harrisonLet/ALANv/docs/3992_final/references.tex

\begin{thebibliography}{9}

\bibitem{stekzer2012}
R.~Stekzer, "Autonomous Sailboat Navigation," Ph.D. dissertation, Center for Computational Intelligence, De Montfort University, Leicester, 2012. [Online]. Available: \url{https://files01.core.ac.uk/download/pdf/228200594.pdf}

\bibitem{saildrone}
Saildrone. [Online]. Available: \url{https://www.saildrone.com/}

\bibitem{noahmarine}
"Ship Rudder," Noah Marine Services. [Online]. Available: \url{https://noah-marineservices.com/ship-rudder-parts-marine-parts/}

\bibitem{sailwings}
"Self Trimming Wingsail---the Pulley/Cord Control System," Sailwings.net, 2026. [Online]. Available: \url{https://www.sailwings.net/pulleycord.html}

\bibitem{sailingcatamarans}
"Keels or Daggerboards, the Pros and Cons," Sailingcatamarans.com. [Online]. Available: \url{https://www.sailingcatamarans.com/index.php/articles/12-to-be-published-mainly-technical/53-keels-or-daggerboards-the-pros-and-cons} (accessed Mar.~22, 2026).

\bibitem{skene2001}
N.~L.~Skene, \emph{Elements of Yacht Design}. Dobbs Ferry, NY: Sheridan House, 2001.

\bibitem{sun2024}
Z.~Sun, A.~Feng, J.~Yu, W.~Zhao, and Y.~Huang, "Development of autonomous sailboat sails and future perspectives: A review," \emph{Renewable and Sustainable Energy Reviews}, vol.~207, no.~114918, Sep.~2024, doi: \url{https://doi.org/10.1016/j.rser.2024.114918}.

\end{thebibliography}
