harrisonLet/ALANv/docs/3992_final/figures/gantt.tex

% ---------------------------------------------------

\begin{table*}[htbp]
\centering
\caption{Project Gantt Chart}
\label{tab:gantt}
\footnotesize
\setlength{\tabcolsep}{2pt}
\newcommand{\gb}{\rule{0.85cm}{5pt}}
\begin{tabular}{|p{3.5cm}|c|c|c|c|c|c|c|c|c|c|c|c|}
\hline
\textbf{Task} & \textbf{Jan} & \textbf{Feb} & \textbf{Mar} & \textbf{Apr} & \textbf{May} & \textbf{Jun} & \textbf{Jul} & \textbf{Aug} & \textbf{Sep} & \textbf{Oct} & \textbf{Nov} & \textbf{Dec} \\
\hline
Hull & \gb & \gb & \gb & \gb & \gb & \gb & & & & & & \\
\hline
Sail & & \gb & \gb & \gb & \gb & \gb & \gb & & & & & \\
\hline
Rudder & & \gb & \gb & \gb & \gb & \gb & & & & & & \\
\hline
Keel & & \gb & \gb & \gb & \gb & \gb & & & & & & \\
\hline
Complete Boat & \gb & \gb & \gb & \gb & \gb & \gb & \gb & & & & & \\
\hline
LoRa & & & \gb & \gb & \gb & \gb & \gb & \gb & \gb & & & \\
\hline
Servos & & \gb & \gb & \gb & \gb & \gb & \gb & \gb & & & & \\
\hline
Sensors & & & \gb & \gb & \gb & \gb & \gb & \gb & \gb & & & \\
\hline
MCU & & & \gb & \gb & \gb & \gb & \gb & \gb & \gb & \gb & & \\
\hline
RC Boat & & & & \gb & \gb & \gb & \gb & \gb & \gb & & & \\
\hline
Positioning & & & & & & & & \gb & \gb & \gb & & \\
\hline
Self Trimming Wingsail & & & & & & & & \gb & \gb & \gb & & \\
\hline
Path Planning & & & & & & & & & \gb & \gb & \gb & \\
\hline
Emergency Recovery & & & & & & & & & & \gb & \gb & \\
\hline
Ground Station Interface & & & & & & & & \gb & \gb & \gb & & \\
\hline
Autonomous Sailboat & & & & & & & & & & \gb & \gb & \gb \\
\hline
\end{tabular}
\end{table*}

% ---------------------------------------------------
