harrisonLet/ALANv/docs/3992_final/sections/conclusion.tex

% ---------------------------------------------------

\section{Conclusion}
\label{sec:conclusion}

The ALAN project demonstrates the feasibility of constructing a low-cost autonomous sailboat using accessible manufacturing techniques and off-the-shelf electronic components. By combining a trimaran hull design with a self-trimming rigid wingsail, the vessel achieves propulsion efficiency without the power consumption of motor-driven sail actuation. The use of a dual-core STM32H755 running FreeRTOS provides the real-time performance required for sensor fusion and control, while LoRa radio enables long-range communication suitable for open-water operation.

Key contributions of this project include: a fiberglass hull manufacturing process using 3D-printed molds accessible to university fabrication labs; a modular mechanical design allowing independent development and testing of keel, rudder, and sail subsystems; and an embedded software architecture distributing navigation and communication across dual processor cores.

Future work includes integration of solar charging for extended mission duration, implementation of machine-learning-based path planning for complex wind conditions, full blue-water endurance testing, and expansion of the sensor suite for environmental data collection applications. The modular design of ALAN facilitates iterative improvement across all subsystems.

% ---------------------------------------------------
