harrisonLet/ALANv/docs/3992_final/figures/images/boatAanatomy_sailTypes.png

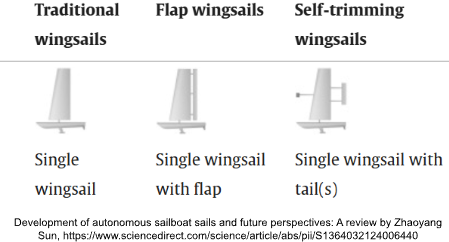
docs/3992_final/figures/images/boatAanatomy_sailTypes.png
