harrisonLet/ALANv/docs/3992_final/figures/images/boatAnatomy_hulls.png

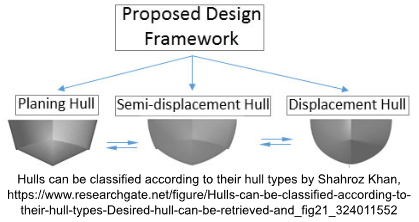
docs/3992_final/figures/images/boatAnatomy_hulls.png
