harrisonLet/ALANv/docs/3992_final/figures/images/selfTrimmingWingsail2.png

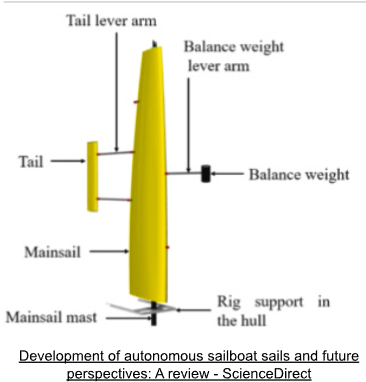
docs/3992_final/figures/images/selfTrimmingWingsail2.png
