harrisonLet/ALANv/docs/3992_final/figures/bom.tex

% ---------------------------------------------------

\begin{table*}[htbp]
\label{tab:bom_rudder}
\centering
\caption{Bill of Materials -- Rudder}
\footnotesize
\begin{tabular}{|p{3.45cm}|p{5.5cm}|p{2.2cm}|p{4.75cm}|}
\hline
\textbf{Category} & \textbf{Item} & \textbf{Status} & \textbf{Notes} \\
\hline
Rudder - Shaft & Shaft Bearing & & R188 Ceramic 1/4 x 1/2 x 3/16 in. \\
\hline
Rudder - Shaft & Rudder Shaft & & SS 304 Round Bar (0.25 in. x 12 in.) \\
\hline
Rudder - Shaft & Rudder Plate & & 304 SS plate 0.25 in. \\
\hline
Rudder - Shaft & Rudder Cross Bolt, Barrel Nut & Delivered & 3/16 in. x 3/4 in. Aluminum Binding Post \\
\hline
Rudder - Mounting & Mounting Bolts & Delivered & 1/4-20 x 1-1/2 in. Zinc Plated Hex Bolt \\
\hline
Rudder - Mounting & Mounting Nuts & Delivered & 1/4-20 SS Nylon Insert Stop Nut \\
\hline
Rudder - Mounting & Mounting Washers & Delivered & 1/4 in. SS Flat Washer \\
\hline
Rudder - Mounting & Rear Mounting Plate & & 304 SS plate 0.25 in. \\
\hline
Rudder - Servo & Marine silicone grease (1 oz) & & \\
\hline
Rudder - Servo & Marine epoxy resin (small kit) & & \\
\hline
Rudder - Servo & Servo-Shaft Coupler & Ordered & 25 Tooth Spline to 1/4 in. Round Bore \\
\hline
Rudder - Servo & Rudder Servo & Delivered & DS3218 MG Digital Servo \\
\hline
Rudder - Servo & Servo Bolt & Delivered & M4-0.7x30mm Hex Bolt \\
\hline
Rudder - Servo & Servo Bolt Nut & & M4 SS Lock Nut \\
\hline
Rudder & PLA Filament & Lab Provided & \\
\hline
\end{tabular}
\end{table*}

\begin{table*}[htbp]
\label{tab:bom_keel}
\centering
\caption{Bill of Materials -- Keel}
\footnotesize
\begin{tabular}{|p{3.45cm}|p{5.5cm}|p{2.2cm}|p{4.75cm}|}
\hline
\textbf{Category} & \textbf{Item} & \textbf{Status} & \textbf{Notes} \\
\hline
Keel & Carbon fiber cloth & & Cover for completed assembly \\
\hline
Keel & Epoxy resin kit & & For composite layup \\
\hline
Keel - Structure & Keel Post & & SS 304 Square Bar (0.5 in. x 7 in.) \\
\hline
Keel - Structure & Keel Mounting Bracket & & 304 SS plate 0.25 in. \\
\hline
Keel - Structure & Mounting Bolts & Delivered & 1/4-20 x 1-1/2 in. Zinc Plated Hex Bolt \\
\hline
Keel - Structure & Mounting Nuts & Delivered & 1/4-20 SS Nylon Insert Stop Nut \\
\hline
Keel - Structure & Mounting Washers & Delivered & 1/4 in. SS Flat Washer \\
\hline
Keel - Structure & Keel Bulb & & SS 304 Round Tube (2 in. x 8.5 in.) \\
\hline
Keel - Structure & Steel Balls & Lab Provided & Ballast \\
\hline
Keel - Fin & Keel Cross Bolt, Barrel Nut & Delivered & 3/16 in. x 3/4 in. Aluminum Binding Post \\
\hline
Keel - Fin & PLA Filament & Lab Provided & \\
\hline
\end{tabular}
\end{table*}

\begin{table*}[htbp]
\label{tab:bom_hull}
\centering
\caption{Bill of Materials -- Hull}
\footnotesize
\begin{tabular}{|p{3.45cm}|p{5.5cm}|p{2.2cm}|p{4.75cm}|}
\hline
\textbf{Category} & \textbf{Item} & \textbf{Status} & \textbf{Notes} \\
\hline
Hull - Mold & Standard PLA Bambu filament & Lab Provided & \\
\hline
Hull - Mold & Rustoleum Filler/Sandable Primer & Purchased & \\
\hline
Hull - Mold & SprayMax 2K Topcoat High Gloss Black & ECE Request & \\
\hline
Hull - Mold & PARTALL Paste \#2 Wax & Delivered & \\
\hline
Hull - Mold & PARTALL Film \#10 PVA & ECE Request & \\
\hline
Hull - Glassing & Fiberglass Cloth Roll & ECE Request & 4 oz plain weave, 50 in. wide \\
\hline
Hull - Glassing & Econostitch Peel Ply & Delivered & \\
\hline
Hull - Glassing & TotalBoat 5:1 Marine Epoxy Kit & ECE Request & \\
\hline
Hull - Tools & Chip Paint Brushes (1 in., 24 pack) & Delivered & \\
\hline
Hull - Tools & Resin Epoxy Mixing Cups (50 pcs) & Delivered & \\
\hline
Hull - Tools & 3M Dynatron Spreaders (3 pack) & Delivered & \\
\hline
Hull - Tools & Wet/Dry Sandpaper Assortment & Purchased & \\
\hline
Hull - PPE & 3M Half Facepiece Respirator & Delivered & \\
\hline
Hull - PPE & 3M P100 Cartridge/Filter & Delivered & \\
\hline
Hull - PPE & Nitrile Exam Gloves & Delivered & \\
\hline
\end{tabular}
\end{table*}

\begin{table*}[htbp]
\label{tab:bom_sail}
\centering
\caption{Bill of Materials -- Rigid Sail}
\footnotesize
\begin{tabular}{|p{3.45cm}|p{5.5cm}|p{2.2cm}|p{4.75cm}|}
\hline
\textbf{Category} & \textbf{Item} & \textbf{Status} & \textbf{Notes} \\
\hline
Rigid Sail & 6061 Aluminum Mast (3 ft) & & \\
\hline
Rigid Sail & 6061 Aluminum Mast (alt. source) & & Metal Supermarket \\
\hline
Rigid Sail & Foam (XPS Rigid Board) & & \\
\hline
Rigid Sail & Cardboard & & \\
\hline
\end{tabular}
\end{table*}

\begin{table*}[htbp]
\label{tab:bom_electronics}
\centering
\caption{Bill of Materials -- Electronics}
\footnotesize
\begin{tabular}{|p{3.45cm}|p{5.5cm}|p{2.2cm}|p{4.75cm}|}
\hline
\textbf{Category} & \textbf{Item} & \textbf{Status} & \textbf{Notes} \\
\hline
Electronics & STM32H7 Dev Board & Delivered & \\
\hline
Electronics & RS485 to UART Adapter & & \\
\hline
Electronics - Sensors & Wind Vane Direction Sensor & Delivered & \\
\hline
Electronics - Sensors & 9-DoF IMU \& Magnetometer & Delivered & BNO055 \\
\hline
Electronics - Sensors & GPS Module & Delivered & NEO-6 \\
\hline
Electronics - Actuators & High-Torque Servo (20 kg-cm) & & Waterproof \\
\hline
Electronics - Power & Solar Panel (10 W, 12 V) & & \\
\hline
Electronics - Power & LiPo Battery (11.1 V, 3S) & & \\
\hline
Electronics - Power & Buck Converters (DC-DC) & & \\
\hline
Electronics - Power & 5 V and 12 V PDB & & \\
\hline
Electronics - Power & Battery BMS & & Overcharge/discharge protection \\
\hline
Electronics - Wireless & Adafruit RFM95W LoRa (915 MHz) & Delivered & \\
\hline
Electronics - Wireless & Adafruit Feather RP2040 w/ RFM95 & Lab Provided & \\
\hline
Electronics - Wireless & uFL SMT Antenna Connector & Delivered & \\
\hline
Electronics - Wireless & SMA to uFL Adapter Cable & & Comes with antennas \\
\hline
Electronics - Wireless & 10 dBi Whip Antenna w/ Adapters & Delivered & \\
\hline
Electronics - Wireless & SMA Male-Female Extension (5 ft) & Delivered & \\
\hline
\end{tabular}
\end{table*}

\begin{table*}[htbp]
\label{tab:bom_miscellaneous}
\centering
\caption{Bill of Materials -- Miscellaneous}
\footnotesize
\begin{tabular}{|p{3.45cm}|p{5.5cm}|p{2.2cm}|p{4.75cm}|}
\hline
\textbf{Category} & \textbf{Item} & \textbf{Status} & \textbf{Notes} \\
\hline
Misc & S6005-2RS Bearing & & 25 mm ID, deck mast partner \\
\hline
Misc & Pelican M60 & & \\
\hline
\end{tabular}
\end{table*}

% ---------------------------------------------------
