harrisonLet/ALANv/docs/3992_final/figures/images/boatAnatomy_parts.png

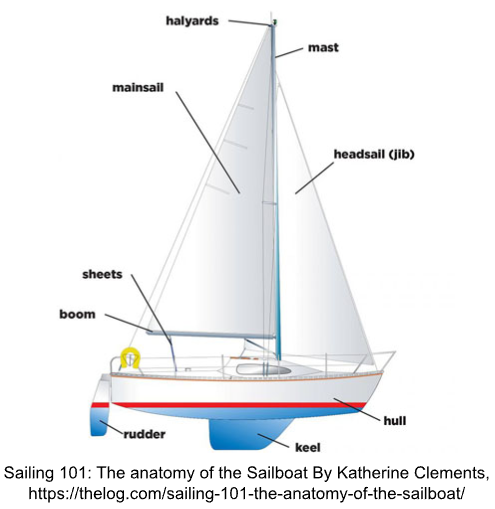
docs/3992_final/figures/images/boatAnatomy_parts.png
