harrisonLet/ALANv/sim/dashboard/models/keel.stl

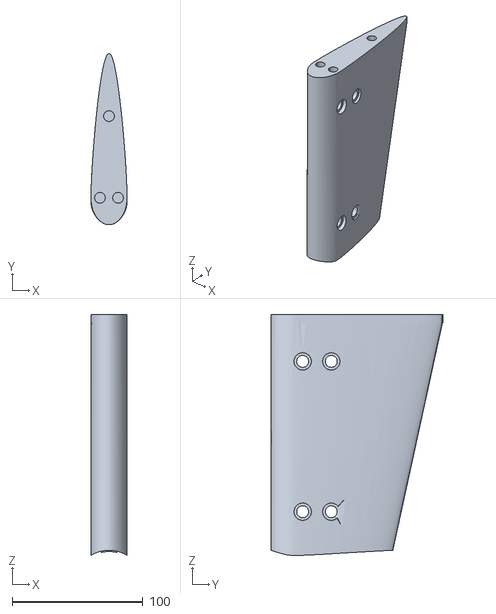
[picture p15: CAD file, 2026-11-07]
sim/dashboard/models/keel.stl
27.6 x 131.2 x 184.4
