harrisonLet/ALANv/sim/dashboard/models/hull_fittings.stl

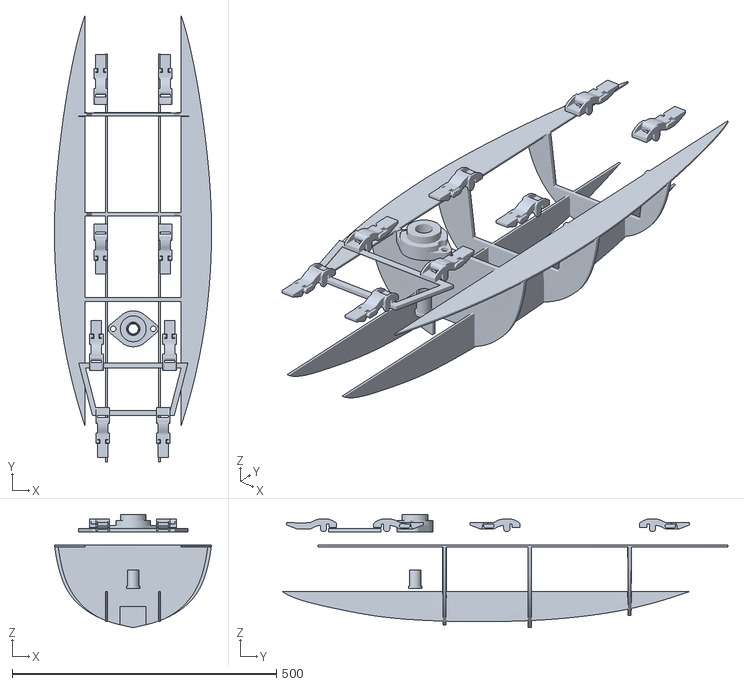
[picture p16: CAD file, 2026-11-07]
sim/dashboard/models/hull_fittings.stl
297.2 x 843.5 x 214.4
