harrisonLet/ALANv/sim/dashboard/models/tail.stl

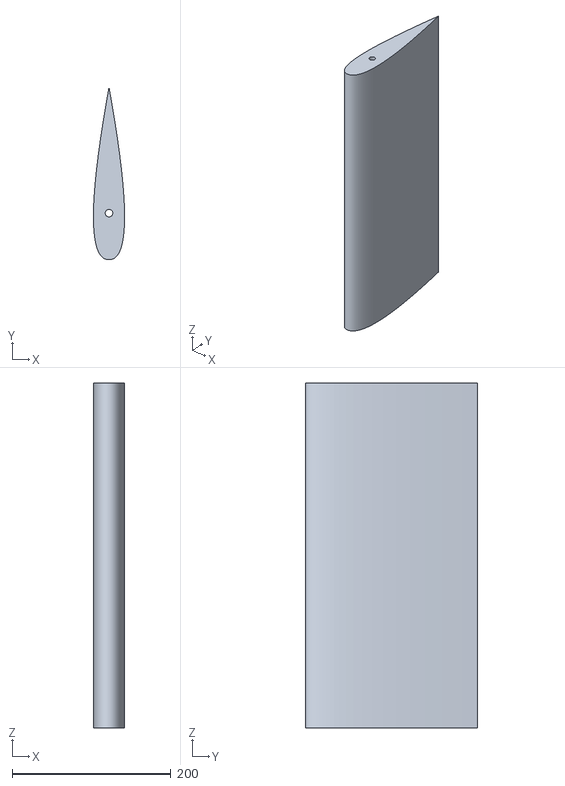
[picture p17: CAD file, 2026-11-07]
sim/dashboard/models/tail.stl
39.3 x 217.4 x 434.8
