harrisonLet/ALANv/hardware/Autonomous_Sailboat/Autonomous_Sailboat.kicad_sch

## KiCad design hardware/Autonomous_Sailboat/Autonomous_Sailboat.kicad_sch (2026-11-07, an earlier design)

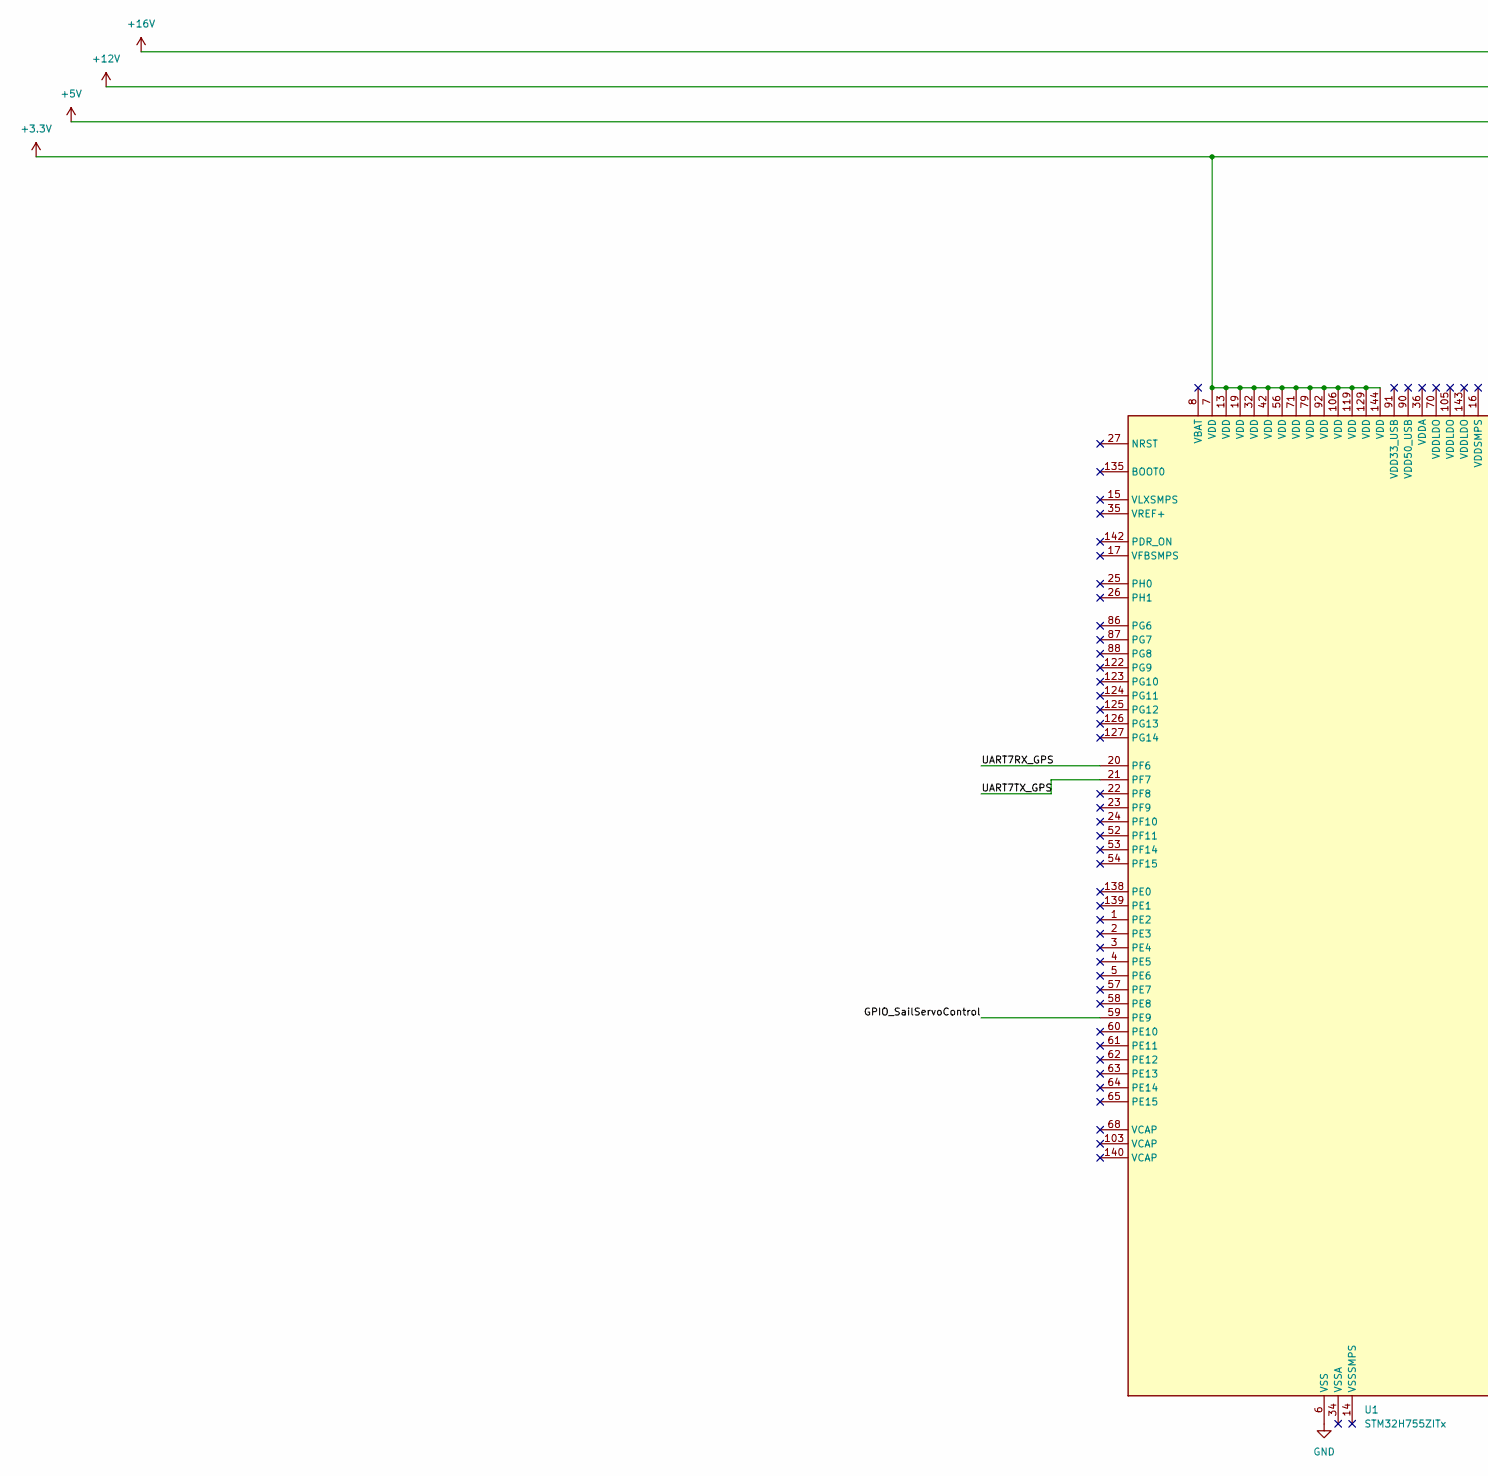
[picture p18: schematic Autonomous_Sailboat.kicad_sch, part in row 1, column 1]

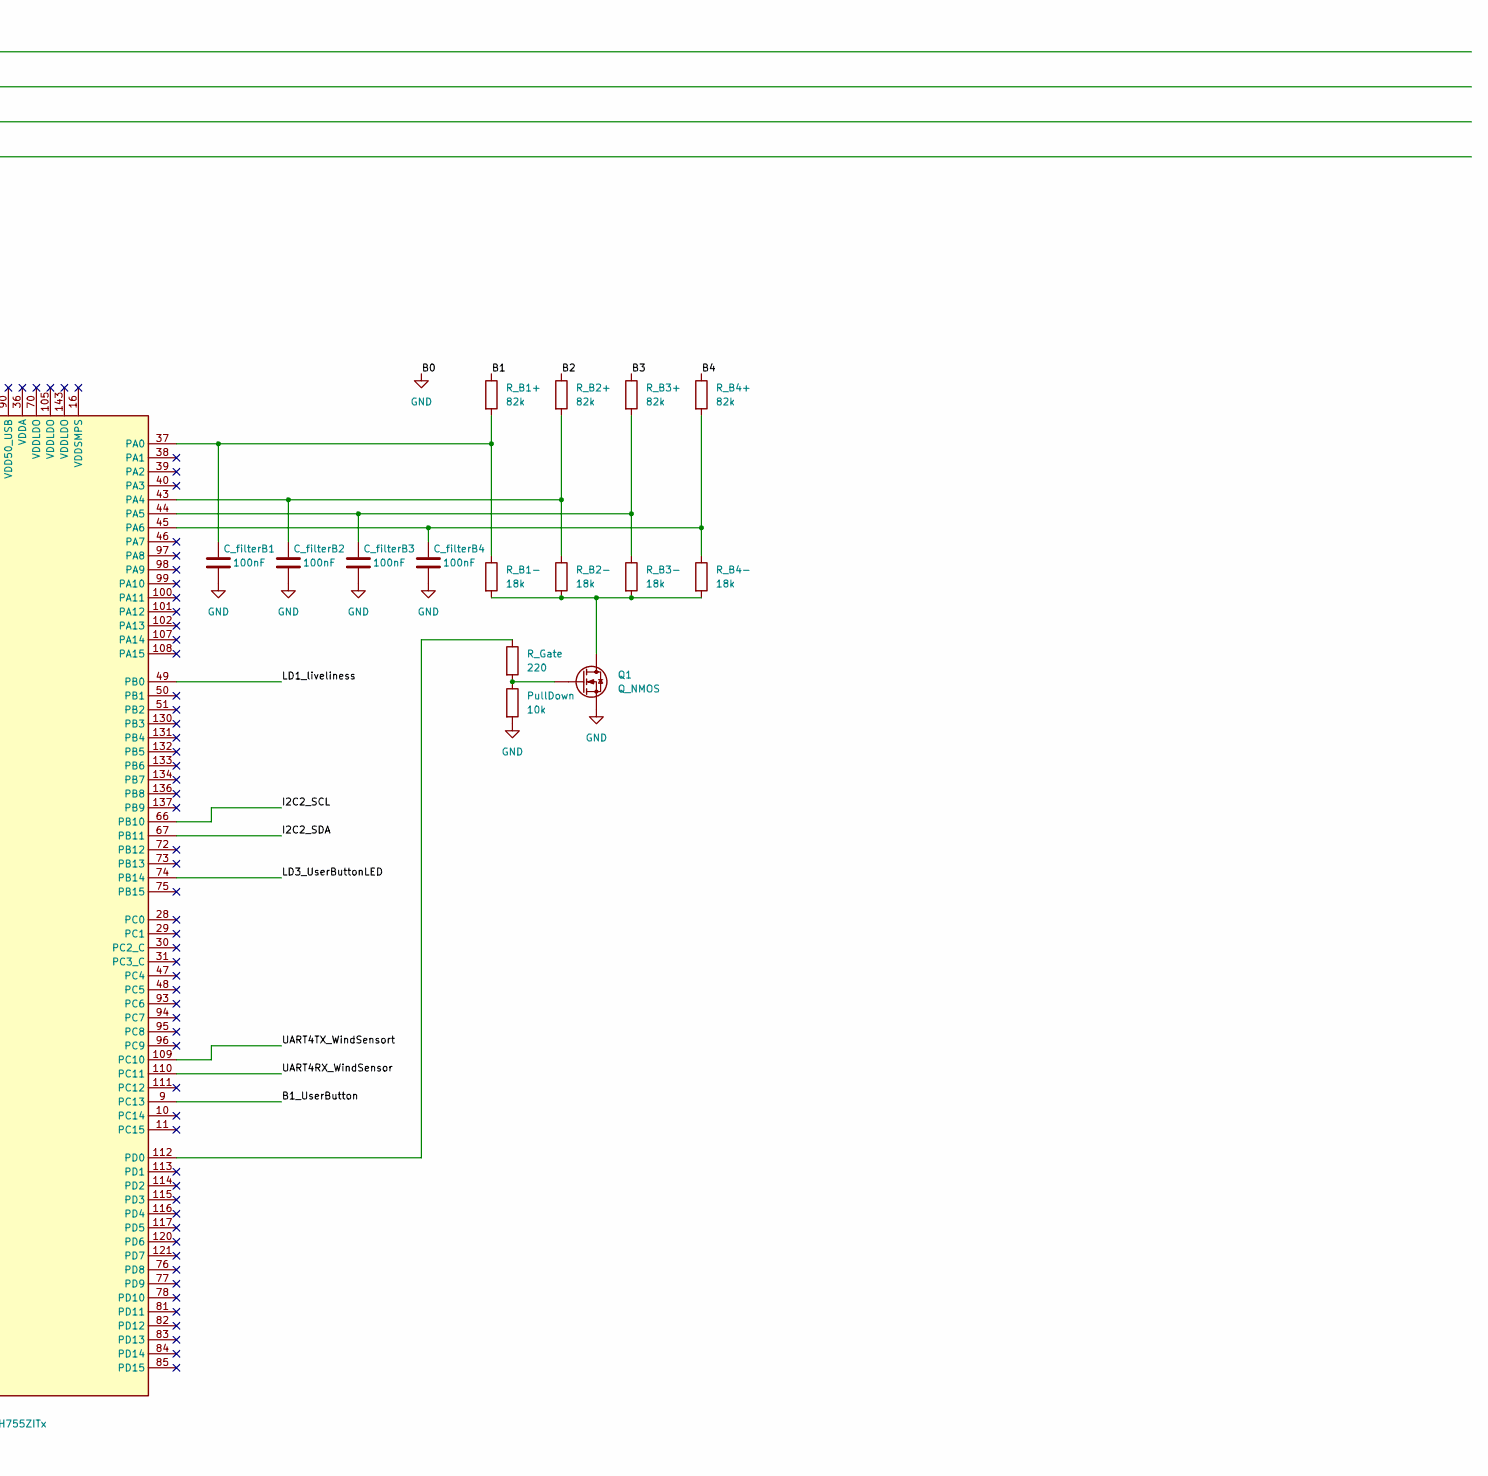
[picture p19: schematic Autonomous_Sailboat.kicad_sch, part in row 1, column 2]

Parts:
C_filterB1, C_filterB2, C_filterB3, C_filterB4: 100nF
PullDown: 10k
Q1: Q_NMOS
R_B1+, R_B2+, R_B3+, R_B4+: 82k
R_B1-, R_B2-, R_B3-, R_B4-: 18k
R_Gate: 220
U1: STM32H755ZITx; LQFP-144_20x20mm_P0.5mm

Connections:
+3.3V: U1.7 (VDD), U1.13 (VDD), U1.19 (VDD), U1.32 (VDD), U1.42 (VDD), U1.56 (VDD), U1.71 (VDD), U1.79 (VDD), U1.92 (VDD), U1.106 (VDD), U1.119 (VDD), U1.129 (VDD), U1.144 (VDD)
B1: R_B1+.1
B1_UserButton: U1.9 (PC13)
B2: R_B2+.1
B3: R_B3+.1
B4: R_B4+.1
GND: C_filterB1.1, C_filterB2.1, C_filterB3.1, C_filterB4.1, PullDown.2, Q1.S, U1.6 (VSS), U1.12 (VSS), U1.18 (VSS), U1.33 (VSS), U1.41 (VSS), U1.55 (VSS), U1.69 (VSS), U1.80 (VSS), U1.89 (VSS), U1.104 (VSS), U1.118 (VSS), U1.128 (VSS), U1.141 (VSS)
GPIO_SailServoControl: U1.59 (PE9)
I2C2_SCL: U1.66 (PB10)
I2C2_SDA: U1.67 (PB11)
LD1_liveliness: U1.49 (PB0)
LD3_UserButtonLED: U1.74 (PB14)
unnamed: C_filterB1.2, R_B1+.2, R_B1-.1, U1.37 (PA0)
unnamed: C_filterB2.2, R_B2+.2, R_B2-.1, U1.43 (PA4)
unnamed: C_filterB3.2, R_B3+.2, R_B3-.1, U1.44 (PA5)
unnamed: C_filterB4.2, R_B4+.2, R_B4-.1, U1.45 (PA6)
unnamed: PullDown.1, Q1.G, R_Gate.2
unnamed: Q1.D, R_B1-.2, R_B2-.2, R_B3-.2, R_B4-.2
unnamed: R_Gate.1, U1.112 (PD0)
UART4RX_WindSensor: U1.110 (PC11)
UART4TX_WindSensort: U1.109 (PC10)
UART7RX_GPS: U1.20 (PF6)
UART7TX_GPS: U1.21 (PF7)
