harrisonLet/ALANv/CM4/Core/Inc/main.h

#define STATUS_LED_PORT GPIOB
#define STATUS_LED_PIN  GPIO_PIN_14  /* red LD3: toggles on every telemetry send */
#define TICK_LED_PORT   GPIOE
#define TICK_LED_PIN    GPIO_PIN_1   /* yellow/orange LD2: toggles on every TIM6 tx_flag tick */
