harrisonLet/ALANv/(commit log)

2026-09-02 Made ground station and added the sail servo to the cmake for build.
2026-09-28 Added ground station vibecode
2026-09-29 added kiCad hardware
    [Autonomous_Sailboat.kicad_pcb, Autonomous_Sailboat.kicad_sch]
2026-09-30 went through and fixed it up so that it actually compiles, untested
    [controller.c, main.c, main.h, sensorGPS.c, system.h]
2026-10-01 Added the minimalizt servo rudder/servo sail code so lora works
2026-10-01 updated the servo code in cm7 to used more shared hardware and code
2026-10-01 got the servos in cm7 to work
2026-10-01 enable the servos for cm4 so that lora works
2026-10-02 minor updates to make the servo check a little less aggressive
2026-10-02 got wind sensor working
2026-10-02 updated servo test angle system
2026-10-09 made the battery shared
2026-10-10 Added defines to battery
2026-10-10 added rudder shared struct
2026-10-12 Added telem r&w, removed interrupt disabling
2026-10-13 shared rudder base
2026-10-14 preliminary implementation of the battery sensor
2026-10-14 Got the battery sensor to work, debug and everything
2026-10-15 slight change to where the telemetry gets printed
2026-10-15 decided sensorpoll was unecessary of a name
2026-10-15 preliminary implementation of encoder
2026-10-17 built the scafold for IMU and wind
2026-10-17 incomplete implementation of IMU hardware init
2026-10-17 Naive complete of IMU hardwareInit
2026-10-17 naive implement of imu
2026-10-17 Ai reviewed imu
2026-10-18 okay, imu is done with a pre-calibrate and calibrate branch
2026-10-18 naive implementation of wind sensor
2026-10-18 So naive that I forgot to implement the wind sensor read
2026-10-18 ai reviewed wind sensor
2026-10-18 wind sensor is good to go
2026-10-19 Added CM4 IPC init (attach) and added its call in CM4 main (sets red LED if fails
2026-10-19 Edited linker to allocate SRAM4 and space for IPC memory region. Also moved cm4IPC init inside main init loop. currently passes LED test
2026-10-19 REFACTOR: renamed all crossCore style files, and variables to use ipc. also updated comments and use snake case for variables and fucntions.
2026-10-19 Replaced bool return values with ipc_status_t flags and a status to string function. Allows more descriptive prints and error messages if something went wrong. Also added clarfying commetns to ring b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
2026-10-19 added a few encoder fail states
2026-10-21 Add firmware-in-the-loop simulator and serial servo console
2026-10-23 Add PID library header
2026-10-23 Added PID controller functions.
2026-10-26 Added sensor polling rate ehcks according to its max supported rate. Added taskDelay checks to skip read if task is running late. wepped bare MS calls in gos, battery, and fusion with pdMS_TO_TICKS t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
2026-10-28 Add rudder arbiter task
2026-10-28 Add the heading pid task
2026-10-29 Implemented the sail PID task.
2026-10-29 Renamed tags in PID and LSP tasks and cleaned up the LSP header.
2026-10-29 wired up the live sail planning to the other PID loops and checked that it built correctly
2026-11-02 Removed all servo control code
2026-11-02 Cut servo setting code
2026-11-02 Removed debug led init, cm4 only controls gpio0 and no other io
2026-11-02 Removed led gpio init
2026-11-02 mergre resolve encoder test shared_conf
2026-11-02 updated battery to use different pin
2026-11-02 Fix encoder range check comparing counts to 360 degrees
2026-11-02 updated validity checking for raw angle (angle reg not burned yet). also edited debug print
2026-11-03 added a check to the sensors so that missing metadata doesn't invalidate telem
2026-11-03 switched the channels
2026-11-03 moved the lora rst to pd15 and battery monitor to pd0 pd4 pb1 pf11
2026-11-04 Added status led for running main loop on cm4. Also added dummy teleme packet for testing.
2026-11-04 Increased telemetry task priority, task was being starved by sensor polling tasks and never copied telem packet into sram. Works now.
2026-11-04 Was getting stuck on failed sensor init, not returns fault and allows cpu to continue
2026-11-04 Changes made to test the sail PID code
2026-11-05 encoder offset upgrade
2026-11-07 updated the wind sensor to get a more stable reading
2026-11-07 updated the main sail pid
2026-11-07 updated the imu to account for a number of current oreintation and offset mishaps
2026-11-07 kicad again
